scott-cjx/Chao-Recruit/docs/schematics/README.md

# Schematic Diagrams
