scott-cjx/Chao-Recruit/docs/assembly/Chao Recruit__Assembly.pdf

1 | 2 | 3 | 4 | 5 | 6

A

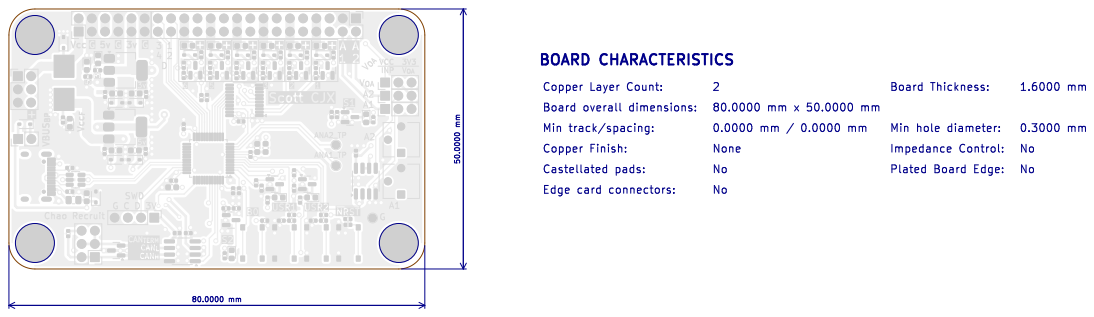
[picture p3: page 1]
Vcc; A2 VBUS_{BP}; SWD G C D 3V; V_{OA} Vcc_{F} VCC 3V3; INP; V_{OA} V_{OA} Chao Recruit; ANA2_TP; ANA1_TP; No No Plated; Board; Edge:; Impedance; Control:; Min; hole diameter: Board; Thickness: No None; 2 Edge card; connectors: Castellated; pads: Board; overall; dimensions: Min track/spacing:; Copper; Layer Count:; No BOARD CHARACTERISTICS; Finish: 50.0000 mm; D Date: 2024-09-29 KiCad E.D.A. 8.0.5 Size: A4; Rev: 1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

https://github.com/scott-cjx/Chao-Recruit
Licensed to Nanyang Venture Formula for NVF-2
License: CERN-OHL-S-2.0 Copyright þÿ©Scott CJX

A

A

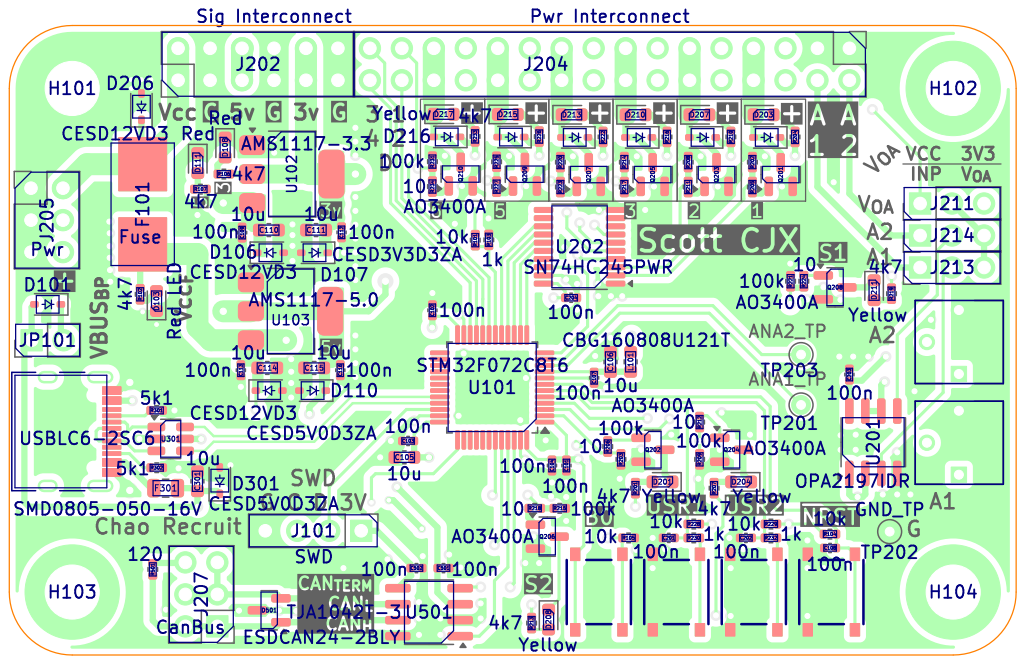
[picture p4: page 2]

https://github.com/scott-cjx/Chao-Recruit

A

A

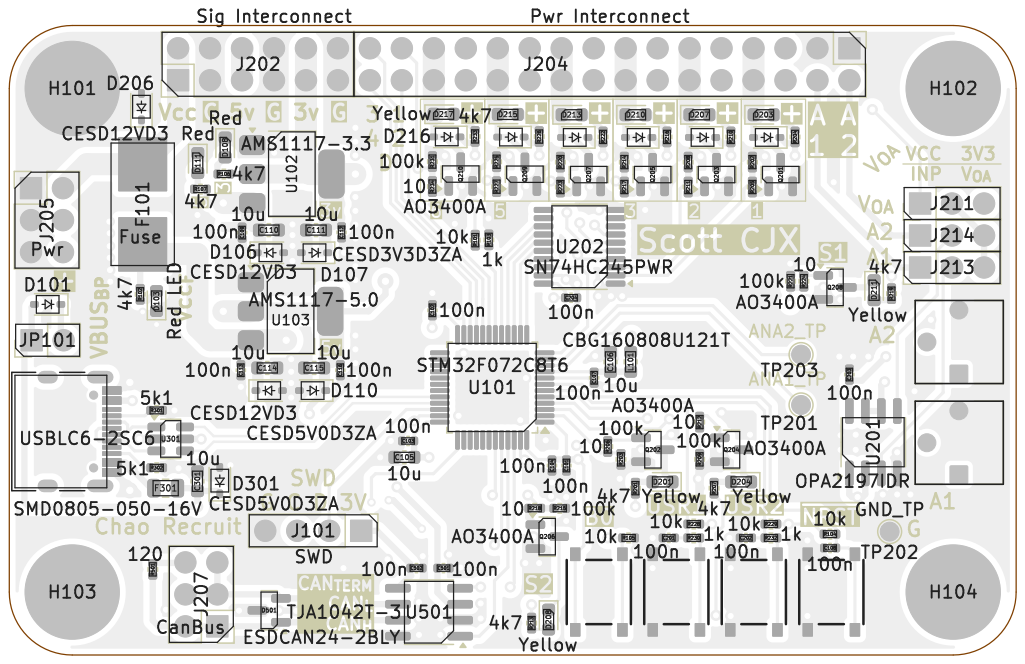
[picture p5: page 3]
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
