scott-cjx/Chao-Recruit/docs/schematics/ChaoRecruit.pdf

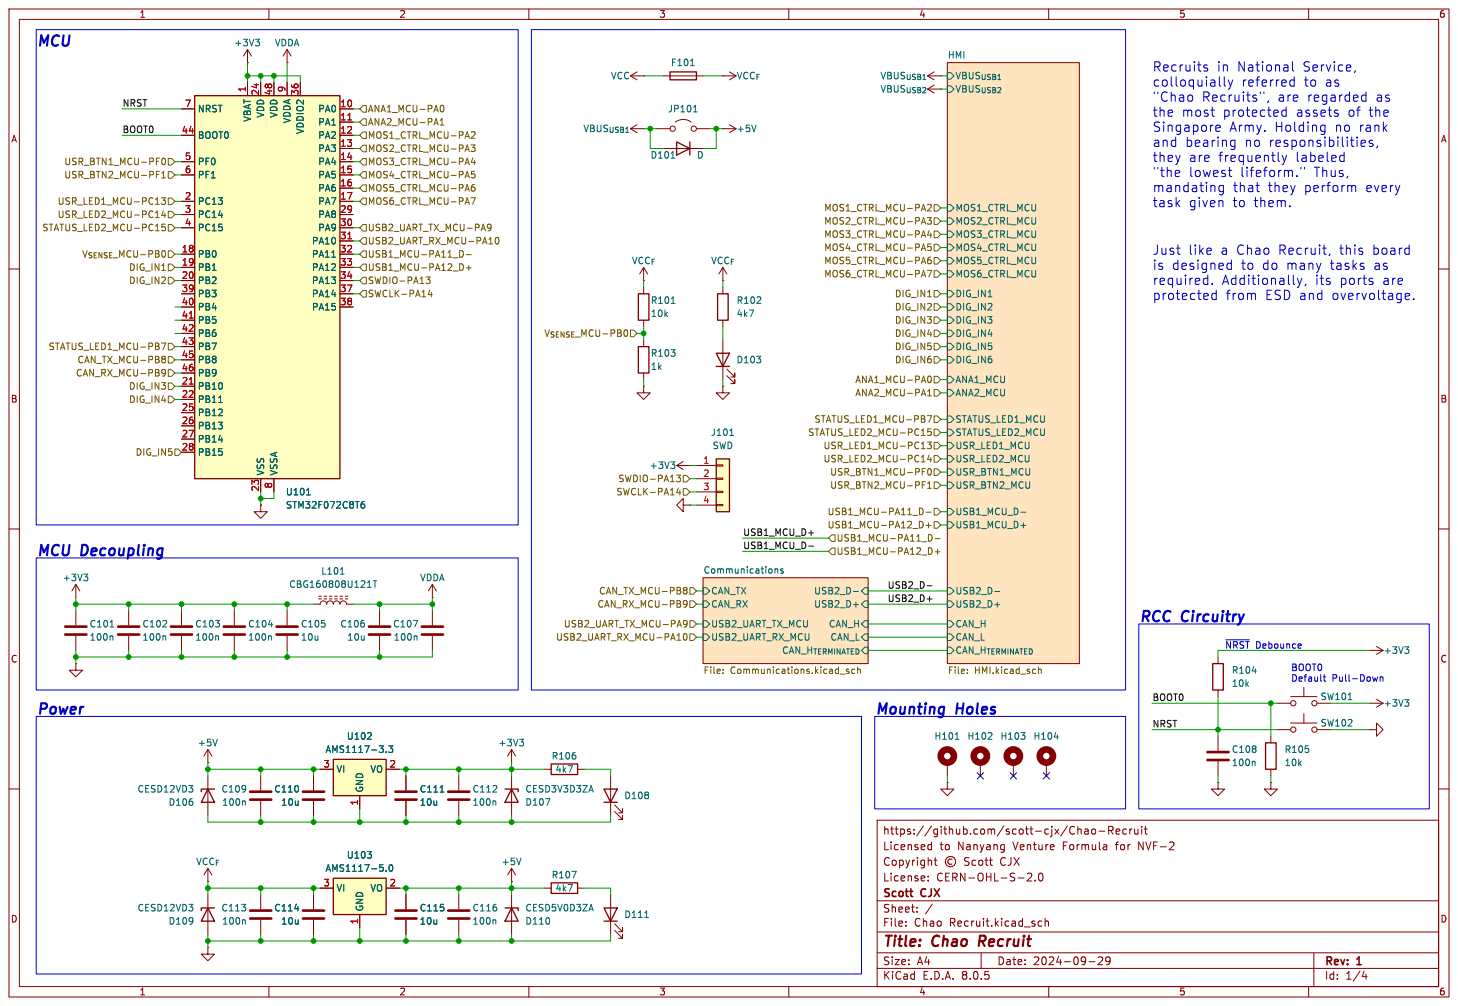
[picture p6: page 1]

Recruits in National Service,
Singapore Army. Holding no rank
and bearing no responsibilities,

1 PA0 10 PA1 11 PA2 12 PA3 13 PA4 14 PA5 15 PA6 16 PA7 17 PB0 18 PB1 19 PC13 2 PB2 20 PB10 21 PB11 22 VSS 23 VDD 24 PB12 25 PB13 26 PB14 27 PB15 28 PA8 29 PC14 3 PA9 30 PA10 31 PA11 32 PA12 33 PA13 34 VDDIO2 36 PA14 37 PA15 38 PB3 39 PC15 4 PB4 40 PB5 41 PB6 42 PB7 43 BOOT0 44 PB8 45 PB9 46 VDD 48 PF0 5 PF1 6 NRST 7 VSSA

task given to them. U101 STM32F072C8T6 VBAT

BOOT0 Default Pull-Down Just like a Chao Recruit, this board
is designed to do many tasks as

~{NRST}Debounce RCC Circuitry

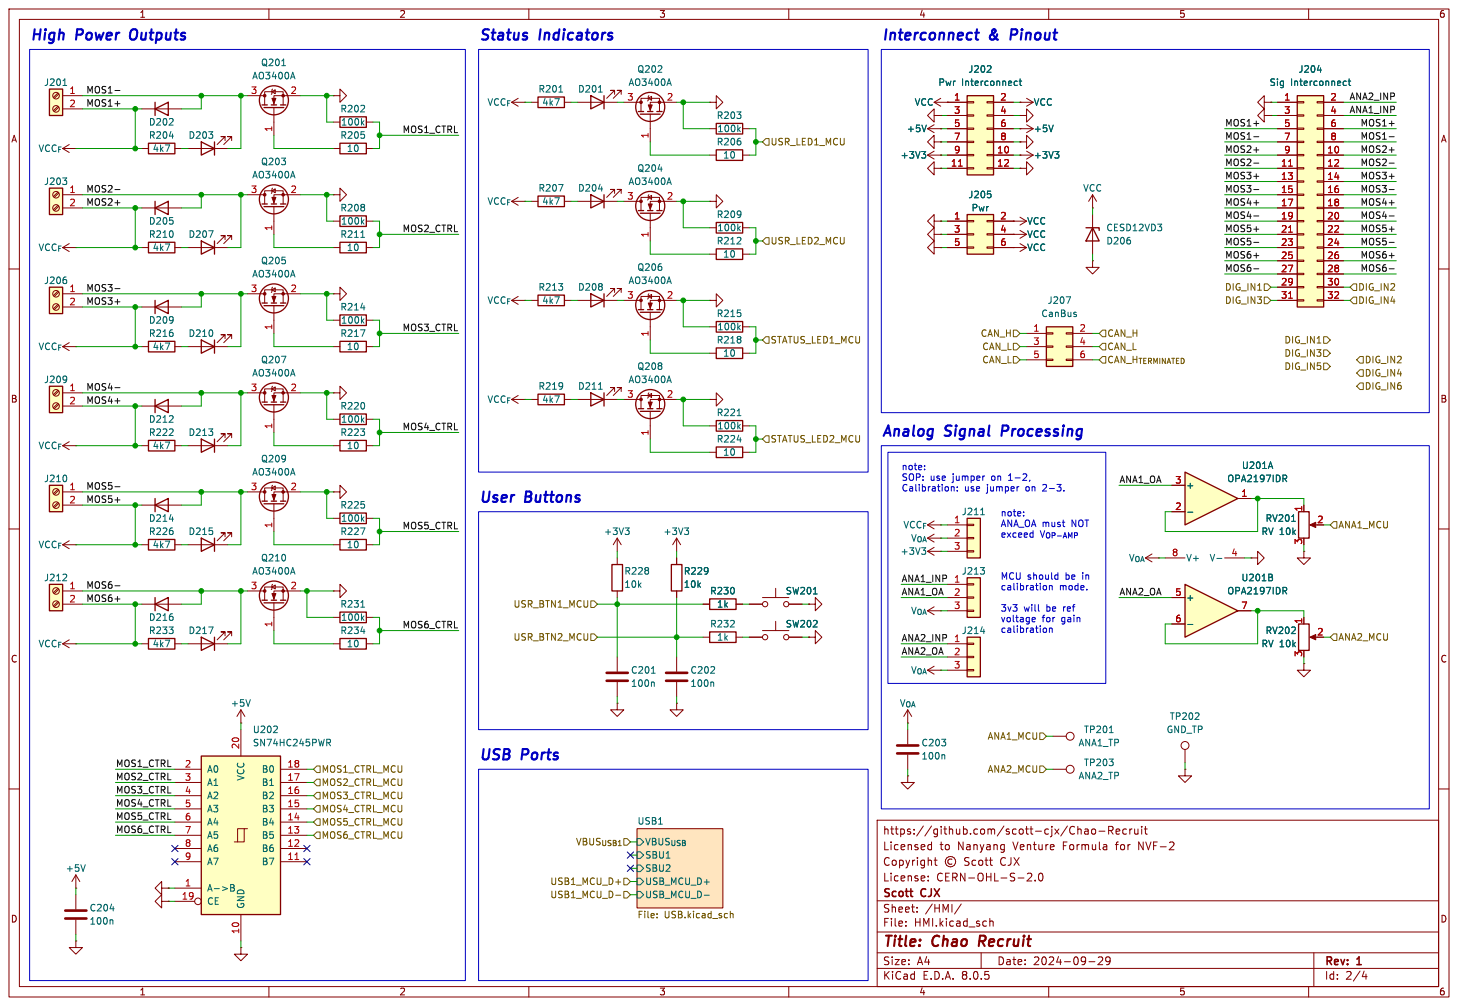
[picture p7: page 2]

MCU should be in

https://github.com/scott-cjx/Chao-Recruit SBU2 SBU1 USB_MCU_D+ USB_MCU_D- VBUS_{USB} USB1 File: USB.kicad_sch

Id: 2/4 Title: Chao Recruit File: HMI.kicad_sch Sheet: /HMI/ Scott CJX

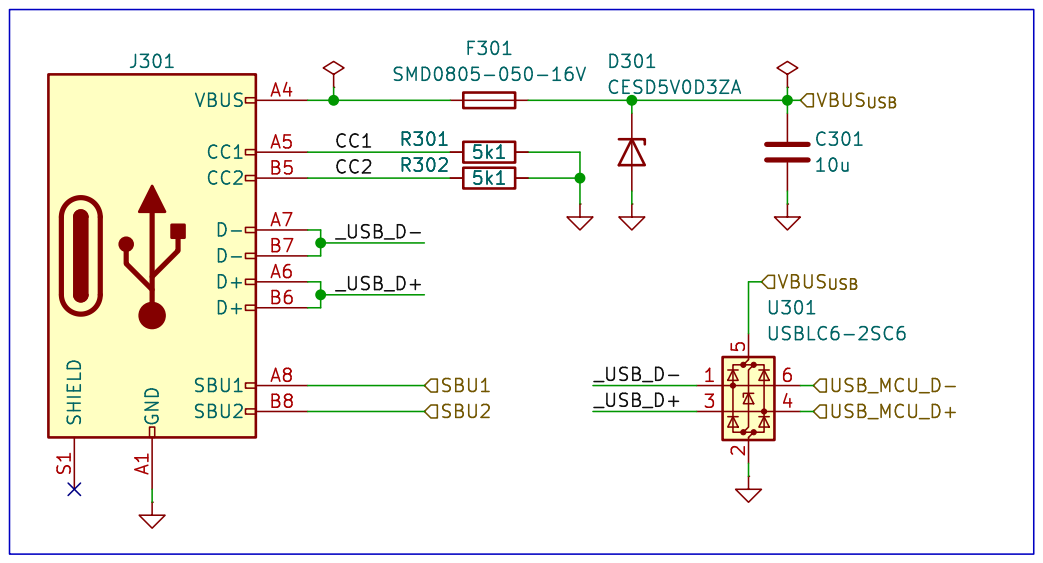
[picture p8: page 3]

https://github.com/scott-cjx/Chao-Recruit

Id: 3/4 Title: Chao Recruit File: USB.kicad_sch Sheet: /HMI/USB1/ Scott CJX

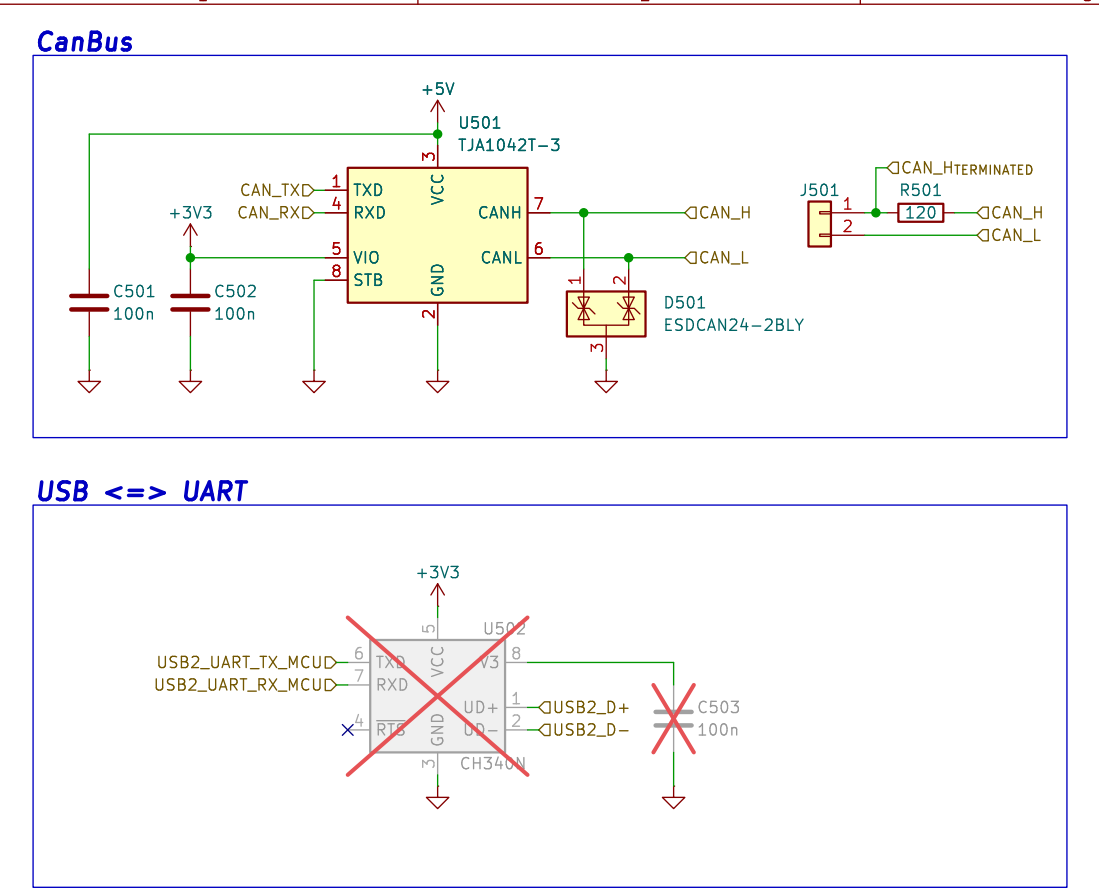
[picture p9: page 4]

3 RXD 4 VIO 5 CANL 6 CANH 7 STB 8 U501 TJA1042T-3 CAN_RX USB2_UART_TX_MCU

3 RXD 4 VIO 5 CANL 6 CANH 7 STB 8

https://github.com/scott-cjx/Chao-Recruit

Id: 5/4 Title: Chao Recruit File: Communications.kicad_sch Sheet: /Communications/ Scott CJX
