scott-cjx/Chao-Recruit/docs/assembly/Chao_Recruit_Colored_TOP.pdf

A

A


https://github.com/scott-cjx/Chao-Recruit
