scott-cjx/Chao-Recruit/HDK/Chao Recruit.kicad_pcb

## KiCad design HDK/Chao Recruit.kicad_pcb (2025-01-06)

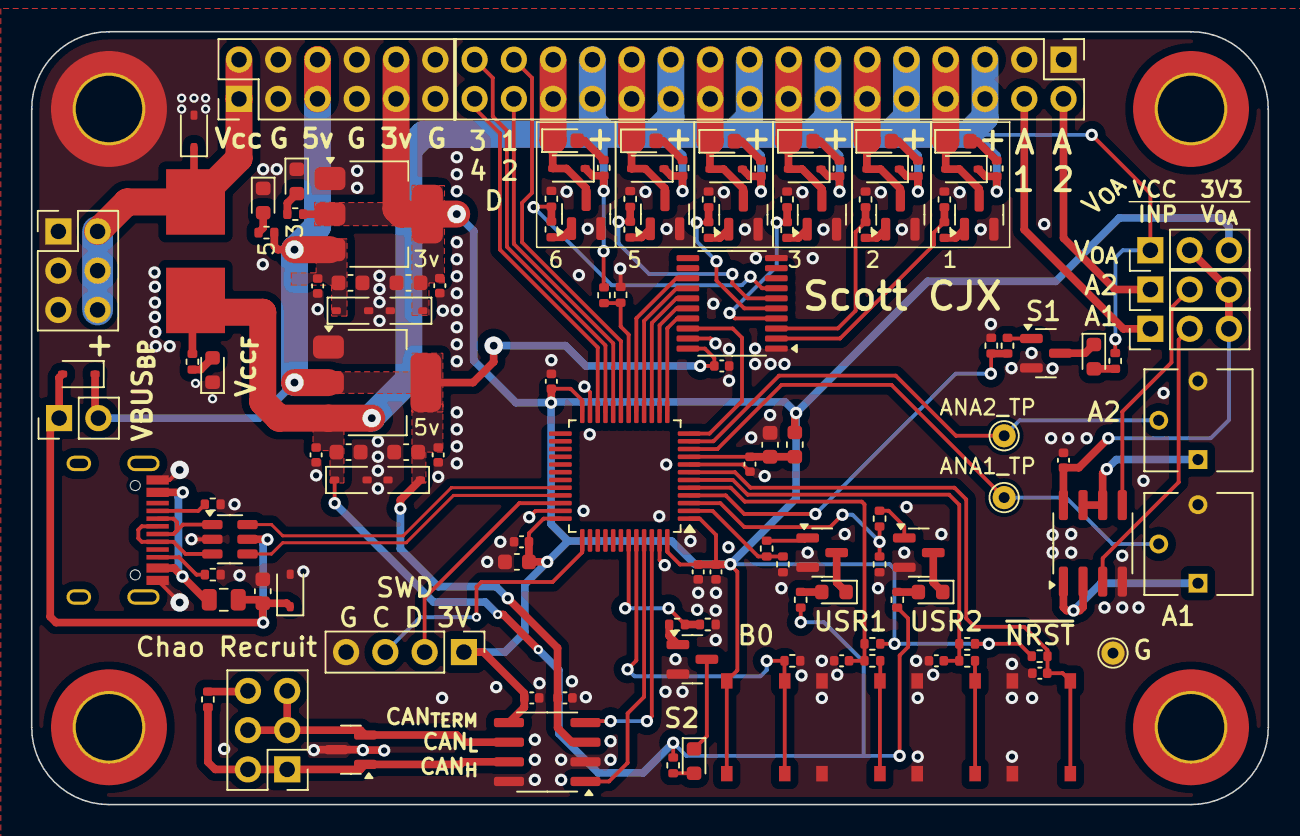
[picture p10: board Chao Recruit.kicad_pcb from above]

Board: 2 copper layers, 80.0 x 50.0 mm, 137 parts (0 on the bottom side), 90 nets.

Parts:
C101, C102, C103, C104, C107, C108, C109, C112, C113, C116, C201, C202, C203, C204, C501, C502: 100n; C_0402_1005Metric
C105, C106, C110, C111, C114, C115, C301: 10u; C_0603_1608Metric
D101, D202, D205, D209, D212, D214, D216: D; D_SOD-323
D103: Red LED; LED_0603_1608Metric
D106, D109, D206: CESD12VD3; D_SOD-323
D107: CESD3V3D3ZA; D_SOD-323
D108, D111: Red; LED_0603_1608Metric
D110, D301: CESD5V0D3ZA; D_SOD-323
D201, D204, D208, D211, D213: Yellow; LED_0603_1608Metric
D203, D207, D210, D215, D217: Yellow LED; LED_0603_1608Metric
D501: ESDCAN24-2BLY; SOT-23
F101: Fuse; FUSE-Littelfuse_Nano2_154x
F301: SMD0805-050-16V; Fuse_0805_2012Metric
H101, H102, H103, H104: MountingHole_Pad; MountingHole_4.3mm_M4_DIN965_Pad_TopBottom
J101: SWD; PinHeader_1x04_P2.54mm_Vertical
J202: Pwr Interconnect; PinHeader_2x06_P2.54mm_Vertical
J204: Sig Interconnect; PinHeader_2x16_P2.54mm_Vertical
J205: Pwr; PinHeader_2x03_P2.54mm_Vertical
J207: CanBus; PinHeader_2x03_P2.54mm_Vertical
J211, J213, J214: Conn_01x03; PinHeader_1x03_P2.54mm_Vertical
J301: USB_C; USBC_HRO_TYPE-C-31-M-12
JP101: Jumper_2_Open; PinHeader_1x02_P2.54mm_Vertical
L101: CBG160808U121T; L_0603_1608Metric
Q201, Q202, Q203, Q204, Q205, Q206, Q207, Q208, Q209, Q210: AO3400A; SOT-23
R101, R104, R105, R228, R229: 10k; R_0402_1005Metric
R102, R106, R107, R201, R204, R207, R210, R213, R216, R219, R222, R226, R233: 4k7; R_0402_1005Metric
R103, R230, R232: 1k; R_0402_1005Metric
R202, R203, R208, R209, R214, R215, R220, R221, R225, R231: 100k; R_0402_1005Metric
R205, R206, R211, R212, R217, R218, R223, R224, R227, R234: 10; R_0402_1005Metric
R301, R302: 5k1; R_0402_1005Metric
R501: 120; R_0402_1005Metric
RV201, RV202: RV 10k; RV_Bourns_3362
SW101, SW102, SW201, SW202: SW_Push; PushBtn_TS-1187A-B-A-B
TP201: ANA1_TP; TestPoint_THTPad_D1.5mm_Drill0.7mm
TP202: GND_TP; TestPoint_THTPad_D1.5mm_Drill0.7mm
TP203: ANA2_TP; TestPoint_THTPad_D1.5mm_Drill0.7mm
U101: STM32F072C8T6; LQFP-48_7x7mm_P0.5mm
U102: AMS1117-3.3; SOT-223-3_TabPin2
U103: AMS1117-5.0; SOT-223-3_TabPin2
U201: OPA2197IDR; SOIC-8_3.9x4.9mm_P1.27mm
U202: SN74HC245PWR; TSSOP-20_4.4x6.5mm_P0.65mm
U301: USBLC6-2SC6; SOT-23-6
U501: TJA1042T-3; SOIC-8_3.9x4.9mm_P1.27mm

Connections:
+3V3: C101.1, C102.1, C103.1, C104.1, C105.1, C111.1, C112.1, C502.1, D107.1 (K), J101.1, J202.9, J202.10, J211.3, L101.1, R104.1, R106.1, R228.1, R229.1, SW101.2, U101.1 (VBAT), U101.24 (VDD), U101.36 (VDDIO2), U101.48 (VDD), U102.2 (VO), U501.5 (VIO)
+5V: C109.1, C110.1, C115.1, C116.1, C204.1, C501.1, D101.1 (K), D106.1 (K), D110.1 (K), J202.5, J202.6, JP101.2 (B), R107.1, U102.3 (VI), U103.2 (VO), U202.20 (VCC), U501.3 (VCC)
/ANA1_MCU-PA0: RV201.2, TP201.1, U101.10 (PA0)
/ANA2_MCU-PA1: RV202.2, TP203.1, U101.11 (PA1)
/BOOT0: R105.1, SW101.1, U101.44 (BOOT0)
/CAN_RX_MCU-PB9: U101.46 (PB9), U501.4 (RXD)
/CAN_TX_MCU-PB8: U101.45 (PB8), U501.1 (TXD)
/Communications/CAN_H: D501.1 (K), J207.1, J207.2, R501.1, U501.7 (CANH)
/Communications/CAN_H_{TERMINATED}: J207.6, R501.2
/Communications/CAN_L: D501.2 (K), J207.3, J207.4, J207.5, U501.6 (CANL)
/DIG_IN1: J204.29, U101.19 (PB1)
/DIG_IN2: J204.30, U101.20 (PB2)
/DIG_IN3: J204.31, U101.21 (PB10)
/DIG_IN4: J204.32, U101.22 (PB11)
/HMI/ANA1_INP: J204.4, J213.1
/HMI/ANA1_OA: J213.2, U201.3 (+)
/HMI/ANA2_INP: J204.2, J214.1
/HMI/ANA2_OA: J214.2, U201.5 (+)
/HMI/MOS1-: D202.2 (A), D203.1 (K), J204.7, J204.8, Q201.3 (D)
/HMI/MOS1_CTRL: R202.1, R205.1, U202.2 (A0)
/HMI/MOS2-: D205.2 (A), D207.1 (K), J204.11, J204.12, Q203.3 (D)
/HMI/MOS2_CTRL: R208.1, R211.1, U202.3 (A1)
/HMI/MOS3-: D209.2 (A), D210.1 (K), J204.15, J204.16, Q205.3 (D)
/HMI/MOS3_CTRL: R214.1, R217.1, U202.4 (A2)
/HMI/MOS4-: D212.2 (A), D213.1 (K), J204.19, J204.20, Q207.3 (D)
/HMI/MOS4_CTRL: R220.1, R223.1, U202.5 (A3)
/HMI/MOS5-: D214.2 (A), D215.1 (K), J204.23, J204.24, Q209.3 (D)
/HMI/MOS5_CTRL: R225.1, R227.1, U202.6 (A4)
/HMI/MOS6-: D216.2 (A), D217.1 (K), J204.27, J204.28, Q210.3 (D)
/HMI/MOS6_CTRL: R231.1, R234.1, U202.7 (A5)
/HMI/USB1/CC1: J301.A5 (CC1), R301.1
/HMI/USB1/CC2: J301.B5 (CC2), R302.1
/HMI/USB1/_USB_D+: J301.A6 (D+), J301.B6 (D+), U301.3 (I/O2)
/HMI/USB1/_USB_D-: J301.A7 (D-), J301.B7 (D-), U301.1 (I/O1)
/MOS1_CTRL_MCU-PA2: U101.12 (PA2), U202.18 (B0)
/MOS2_CTRL_MCU-PA3: U101.13 (PA3), U202.17 (B1)
/MOS3_CTRL_MCU-PA4: U101.14 (PA4), U202.16 (B2)
/MOS4_CTRL_MCU-PA5: U101.15 (PA5), U202.15 (B3)
/MOS5_CTRL_MCU-PA6: U101.16 (PA6), U202.14 (B4)
/MOS6_CTRL_MCU-PA7: U101.17 (PA7), U202.13 (B5)
/NRST: C108.1, R104.2, SW102.1, U101.7 (NRST)
/STATUS_LED1_MCU-PB7: R215.1, R218.1, U101.43 (PB7)
/STATUS_LED2_MCU-PC15: R221.1, R224.1, U101.4 (PC15)
/SWCLK-PA14: J101.3, U101.37 (PA14)
/SWDIO-PA13: J101.2, U101.34 (PA13)
/USB1_MCU_D+: U101.32 (PA11), U301.6 (I/O1)
/USB1_MCU_D-: U101.33 (PA12), U301.4 (I/O2)
/USR_BTN1_MCU-PF0: C201.1, R228.2, R230.1, U101.5 (PF0)
/USR_BTN2_MCU-PF1: C202.1, R229.2, R232.1, U101.6 (PF1)
/USR_LED1_MCU-PC13: R203.1, R206.1, U101.2 (PC13)
/USR_LED2_MCU-PC14: R209.1, R212.1, U101.3 (PC14)
/V_{SENSE}_MCU-PB0: R101.2, R103.1, U101.18 (PB0)
GND: C101.2, C102.2, C103.2, C104.2, C105.2, C106.2, C107.2, C108.2, C109.2, C110.2, C111.2, C112.2, C113.2, C114.2, C115.2, C116.2, C201.2, C202.2, C203.2, C204.2, C301.2, C501.2, C502.2, D103.1 (K), D106.2 (A), D107.2 (A), D108.1 (K), D109.2 (A), D110.2 (A), D111.1 (K), D206.2 (A), D301.2 (A), D501.3 (A), H101.1, J101.4, J202.3, J202.4, J202.7, J202.8, J202.11, J202.12, J204.1, J204.3, J205.1, J205.3, J205.5, J301.A1 (GND), J301.A12 (GND), J301.B1 (GND), J301.B12 (GND), Q201.2 (S), Q202.2 (S), Q203.2 (S), Q204.2 (S), Q205.2 (S), Q206.2 (S), Q207.2 (S), Q208.2 (S), Q209.2 (S), Q210.2 (S), R103.2, R105.2, R202.2, R203.2, R208.2, R209.2, R214.2, R215.2, R220.2, R221.2, R225.2, R231.2, R301.2, R302.2, RV201.3, RV202.3, SW102.2, SW201.2, SW202.2, TP202.1, U101.8 (VSSA), U101.23 (VSS), U101.35 (VSS), U101.47 (VSS), U102.1 (GND), U103.1 (GND), U201.4 (V-), U202.1 (A->B), U202.10 (GND), U202.19 (CE), U301.2 (GND), U501.2 (GND), U501.8 (STB)
unnamed: D103.2 (A), R102.2
unnamed: D108.2 (A), R106.2
unnamed: D111.2 (A), R107.2
unnamed: D201.2 (A), R201.2
unnamed: D201.1 (K), Q202.3 (D)
unnamed: D203.2 (A), R204.2
unnamed: D204.2 (A), R207.2
unnamed: D204.1 (K), Q204.3 (D)
unnamed: D207.2 (A), R210.2
unnamed: D208.2 (A), R213.2
unnamed: D208.1 (K), Q206.3 (D)
unnamed: D210.2 (A), R216.2
unnamed: D211.2 (A), R219.2
unnamed: D211.1 (K), Q208.3 (D)
unnamed: D213.2 (A), R222.2
unnamed: D215.2 (A), R226.2
unnamed: D217.2 (A), R233.2
unnamed: F301.1, J301.A4 (VBUS), J301.A9 (VBUS), J301.B4 (VBUS), J301.B9 (VBUS)
unnamed: Q201.1 (G), R205.2
unnamed: Q202.1 (G), R206.2
unnamed: Q203.1 (G), R211.2
unnamed: Q204.1 (G), R212.2
unnamed: Q205.1 (G), R217.2
unnamed: Q206.1 (G), R218.2
unnamed: Q207.1 (G), R223.2
unnamed: Q208.1 (G), R224.2
unnamed: Q209.1 (G), R227.2
unnamed: Q210.1 (G), R234.2
unnamed: R230.2, SW201.1
unnamed: R232.2, SW202.1
unnamed: RV201.1, U201.1, U201.2 (-)
unnamed: RV202.1, U201.6 (-), U201.7
VBUS_{USB1}: C301.1, D101.2 (A), D301.1 (K), F301.2, JP101.1 (A), U301.5 (VBUS)
VCC: D206.1 (K), F101.1, J202.1, J202.2, J205.2, J205.4, J205.6
VCC_{F}: C113.1, C114.1, D109.1 (K), D202.1 (K), D205.1 (K), D209.1 (K), D212.1 (K), D214.1 (K), D216.1 (K), F101.2, J204.5, J204.6, J204.9, J204.10, J204.13, J204.14, J204.17, J204.18, J204.21, J204.22, J204.25, J204.26, J211.1, R101.1, R102.1, R201.1, R204.1, R207.1, R210.1, R213.1, R216.1, R219.1, R222.1, R226.1, R233.1, U103.3 (VI)
VDDA: C106.1, C107.1, L101.2, U101.9 (VDDA)
V_{OA}: C203.1, J211.2, J213.3, J214.3, U201.8 (V+)
