scott-cjx/Chao-Recruit/(commit log)

2025-01-06 try download button
2025-01-06 fix download button
