scott-cjx/Chao-Recruit/(notices)

Notices in the files:
HDK/USB.kicad_sch:
Copyright © Scott CJX
